phguimaraes15/PID-Ball-and-Beam/README.md

# Trabalho de modelagem

Controle PID de um sistema Ball and Beam.

Realizado em julho de 2023
